daniw/slimsata/README.md

slimsata
========

Adapter um eine 2.5" SATA Festplatte in einen Slimline CD/DVD Slot einzubauen. 

Die Abmessungen des Laufwerks und der Blende werden dabei von einem HP ProBook 4740s genommen. 

Der mechanische Adapter wird mit einem 3D-Drucker ausgedruckt. Die elektrische Verbindung wird mit einer Adapterplatine sichergestellt. 

Da beim Stecker für die Stromversorgung des Slimline Laufwerks nur 5V vorhanden sind funktioniert dieser Adapter nur mit Festplatten, die für den Betrieb nur 5V benötigen. Das ist aus den technischen Unterlagen der jeweiligen Festplatte zu entnehmen.
