daniw/slimsata/doc/schaltung.tex

% coding:utf-8

\section{Schaltung}
Die Schaltung besteht nur aus den zwei Steckverbindern. Die Datenleitungen 
sind direkt durchverbunden. Da der Anschluss für ein optisches Laufwerk 
für die Versorgung nur $5 V$ bietet, werden nur diese an die Festplatte 
weitergereicht. Somit können nur Festplatten verwendet werden, welche die 
$3.3 V$ und die $12 V$ Leitung nicht benötigen. Das kann aus dem jeweiligen 
Datenblatt entnommen werden.
