daniw/slimsata/doc/requirements.tex

% coding:utf-8

\section{Anforderungen}
Es soll ein Adapter entwickelt werden, welcher den Einbau einer Harddisk in 
einen Slimline Slot erlaubt. Als Vorlage für die Abmasse und die Position 
des Steckers dient ein HP Probook 4740s. Sowohl der Anschluss für Daten als 
auch für die Stromversorgung sollen verbunden werden. 

\begin{table}[h!]
  \begin{tabular}{@{}ll}
    \textbf{Anforderung}        & \textbf{Wert} \\
    Versorgung                  & $5$ V \\
    Längenunterschied Datenleitungspaare & $< 5$ mil \\
    Impedanz Datenleitungspaare & $100 \Omega \pm 10 \%$ \\
  \end{tabular}
\end{table}
