daniw/slimsata/hardware/slimsata.sch

## EAGLE design hardware/slimsata.sch (2013-08-03)

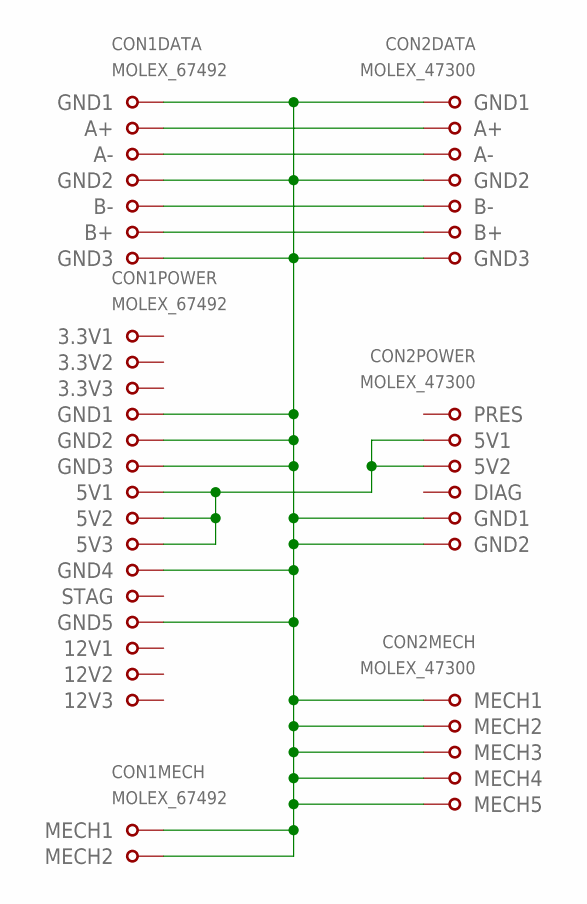
[picture p2: schematic slimsata.sch]

Parts:
CON1: MOLEX_67492
CON2: MOLEX_47300; MOLEX_47300-100X/101X/102X/103X

Connections:
A_N: CON1.S3 (A-), CON2.S3 (A-)
A_P: CON1.S2 (A+), CON2.S2 (A+)
B_N: CON1.S5 (B-), CON2.S5 (B-)
B_P: CON1.S6 (B+), CON2.S6 (B+)
GND: CON1.MECH1, CON1.MECH2, CON1.P4 (GND1), CON1.P5 (GND2), CON1.P6 (GND3), CON1.P10 (GND4), CON1.P12 (GND5), CON1.S1 (GND1), CON1.S4 (GND2), CON1.S7 (GND3), CON2.MECH1, CON2.MECH2, CON2.MECH3, CON2.MECH4, CON2.MECH5, CON2.P5 (GND1), CON2.P6 (GND2), CON2.S1 (GND1), CON2.S4 (GND2), CON2.S7 (GND3)
unnamed: CON1.P7 (5V1), CON1.P8 (5V2), CON1.P9 (5V3), CON2.P2 (5V1), CON2.P3 (5V2)
