daniw/slimsata/(commit log)

2013-07-04 Schema und Bibliothek vorbereitet
    [slimsata.sch]
2013-07-05 PDF der Doku im .gitignore eingetragen
2013-07-05 Ergänzungen bez. Adapter und Stromversorgung
2013-07-09 NAme und Wert bei Symbolen ergänzt
2013-07-10 Footprint zu Molex 47018 ohne Befestigung erstellt
2013-07-11 Footprint Molex 47018 mit Befestigung
2013-07-12 Schema angefangen
    [slimsata.sch]
2013-07-13 Platine angefangen, Bauteile grob platziert
    [slimsata.brd]
2013-07-14 Stecker neu platziert
    [slimsata.brd]
2013-07-14 Signaleitungen geroutet
    [slimsata.brd, slimsata.sch]
2013-07-14 Massefläche eingefügt
    [slimsata.brd]
2013-07-14 Version mit HDD am Rand des Adapters
    [slimsata-2.brd, slimsata-2.sch]
2013-07-14 Vias um Datenleitungen
    [slimsata-2.brd]
2013-07-14 Masse von Hand verlegt
    [slimsata-2.brd]
2013-07-14 Masse nochmal neu
    [slimsata-2.brd]
2013-07-15 bei Variante 1 Versorgung geroutet
    [slimsata.brd]
2013-07-15 schmale Variante 3
    [slimsata-3.brd, slimsata-3.sch]
2013-07-16 kleine Änderungen
    [slimsata-2.brd]
2013-07-19 Stecker Molex 67492 platziert, Platinenumrisse angepasst
    [slimsata.brd, slimsata.sch]
2013-07-19 Datenleitungen mit einer Impedanz von 100 Ohm geroutet
    [slimsata.brd]
2013-07-19 Abstände Datenleitungen <-> GND auf 20 mil vergrössert.
    [slimsata.brd, slimsata.sch]
2013-07-20 andere Leitungsführung der Datenleitungen, ohne Längenausgleich
    [slimsata.brd]
2013-07-21 Längenanpassung
    [slimsata.brd, slimsata.sch]
2013-07-22 signals named for differential pair routing
    [slimsata.sch]
2013-07-22 signals routed as differential pair without length matching
    [slimsata.brd, slimsata.sch]
2013-07-23 Längenausgleich auf 0.4 mil
    [slimsata.brd]
2013-07-26 Package des Molex 447300 von -1005 zu 1020 geändert
    [slimsata.brd, slimsata.sch]
2013-08-03 Name beim Device angepasst
2013-08-03 Molex 47300 durch Kombivariante ersetzt
    [slimsata.brd, slimsata.sch]
2013-09-08 Datenblätter der Molex Steckverbinder
2013-09-13 Formel und Berechnung Impedanz
